ckpt-gthb/pfeilzaehler3000/docs/images/lid-art.png

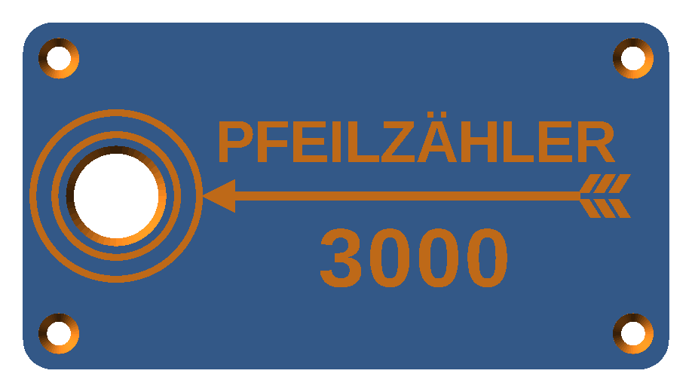
docs/images/lid-art.png
