ckpt-gthb/pfeilzaehler3000/housing/PfeilZaehler3000-lid.stl

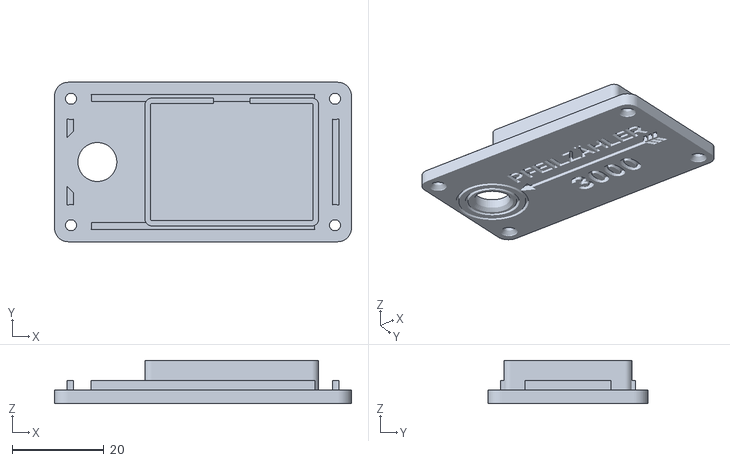
[picture p17: CAD file, 2026-10-11]
housing/PfeilZaehler3000-lid.stl
64.8 x 34.8 x 9.39
