ckpt-gthb/pfeilzaehler3000/housing/PfeilZaehler3000-insert-test.stl

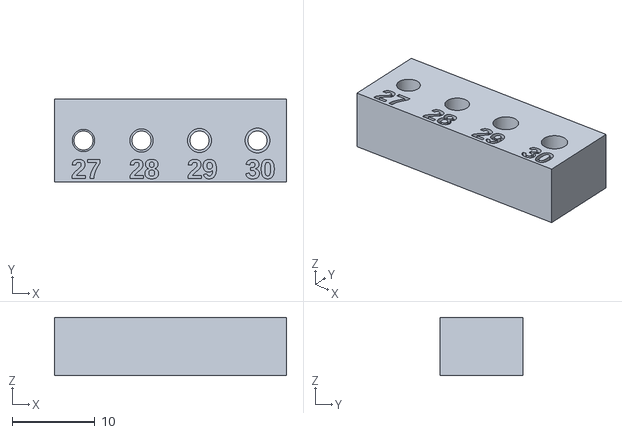
[picture p18: CAD file, 2026-10-11]
housing/PfeilZaehler3000-insert-test.stl
28.0 x 10.0 x 7.00
