ckpt-gthb/pfeilzaehler3000/housing/PfeilZaehler3000-lid-2color.3mf

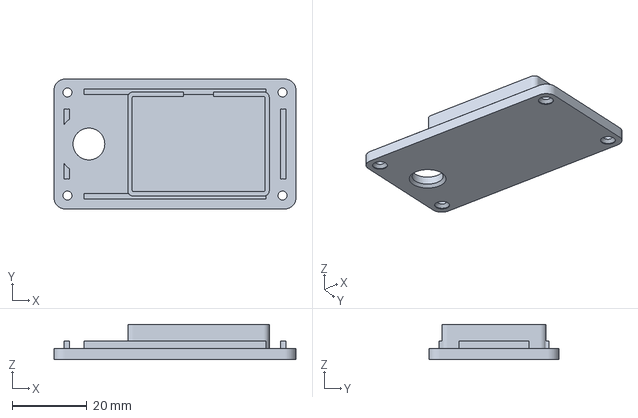
[picture p19: CAD file, 2026-10-11]
housing/PfeilZaehler3000-lid-2color.3mf
64.8 x 34.8 x 9.39 mm
