ckpt-gthb/pfeilzaehler3000/housing/PfeilZaehler3000-frame.stl

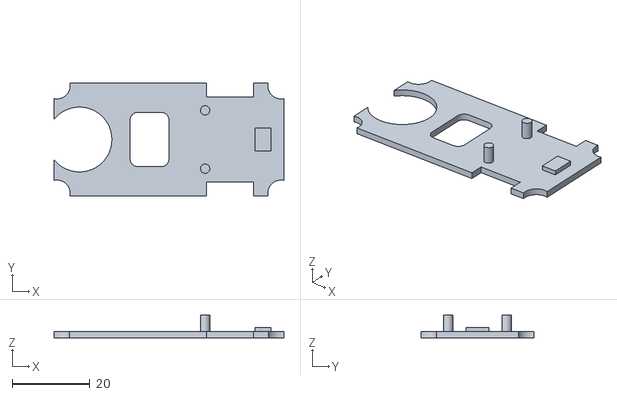
[picture p20: CAD file, 2026-10-11]
housing/PfeilZaehler3000-frame.stl
59.2 x 29.2 x 5.90
