ckpt-gthb/pfeilzaehler3000/housing/PfeilZaehler3000-base.stl

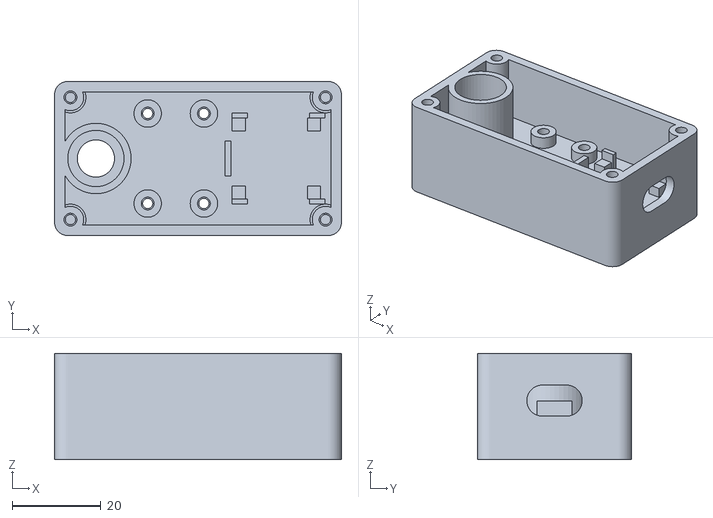
[picture p21: CAD file, 2026-10-11]
housing/PfeilZaehler3000-base.stl
64.8 x 34.8 x 24.0
