ckpt-gthb/pfeilzaehler3000/(commit log)

2026-10-11 Release 1.7 initial public
    [PfeilZaehler3000-base.stl, PfeilZaehler3000-frame.stl, PfeilZaehler3000-insert-test.stl, PfeilZaehler3000-lid-2color.3mf, PfeilZaehler3000-lid.stl, pod.scad]
2026-10-12 Release 1.8
    ## Release 1.8 – 12 October 2026
    - Allow for multiple archers using the pod at the same range at the same time
    - Pod firmware 1.6: every pod has its own Bluetooth name `PfeilZaehler3000-XXXX` (from its
    Bluetooth address) and sends the ID in its advertising; the name is printed on the Serial
    Monitor.
    - Debug firmware rebuilt on firmware 1.6.
    - Phone page 1.8: remembers the chosen pod and only reconnects to that one; shows the pod's name.
    - Watch app 1.2: remembers the first pod it connects to and ignores other pods; hold UP to use a
    different pod; shows the pod ID.
    - Documentation: shared web address and own copies, finding your pod, Garmin Archery activity.
2026-10-17 Release 2.1
    * Send the mounting point only when it is changed on that device
    Phone page and watch app sent their stored mounting point with every
    change of arrows per end or end pause. A mounting point found by the
    calibration while that device was offline was then overwritten.
    * Pod firmware 2.1: shot details only for confirmed shots
    - At the jolt only the bow's axes and the history position are noted;
    the details are worked out once the jolt is confirmed as a shot.
    Fixes #3.
    - Calibration wakes the sensors from idle first. Fixes #8.
    - Aim movement uses the measured gyro timing. Fixes #10.
    * Phone page 2.1: safer storage, backup reminder, end colour
    - The pod is cleared after a syn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
    [PfeilZaehler3000.ino, PfeilZaehler3000Debug.ino]
